samlahde/embedded_systems_course/README.md

# embedded_systems_course
Robotic car for embedded systems project course
