samlahde/embedded_systems_course/shield/ardu_auto2_0.kicad_pcb

## KiCad design shield/ardu_auto2_0.kicad_pcb (2022-03-04)

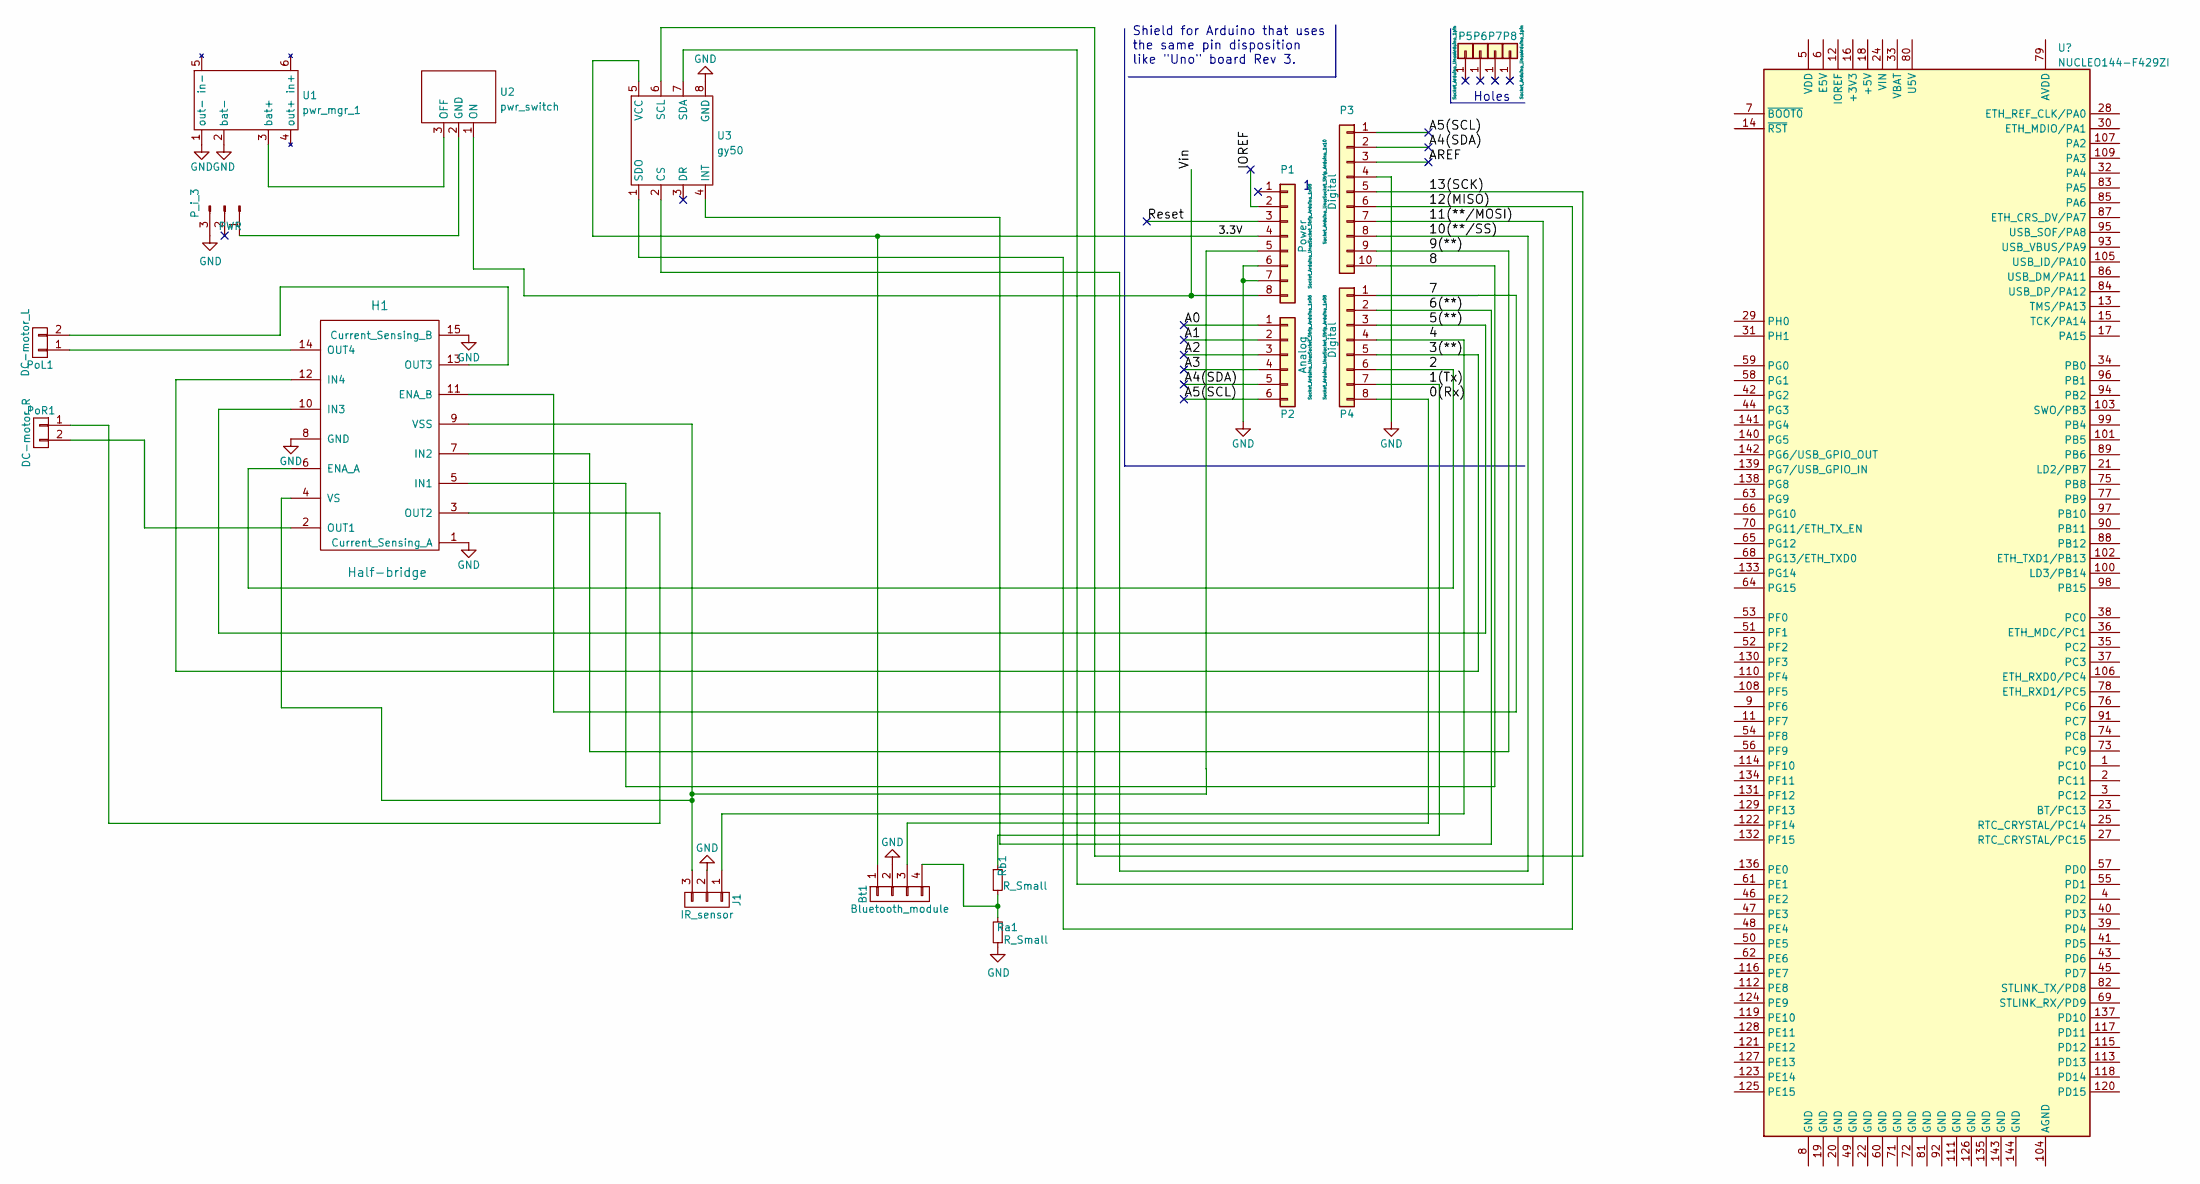
[picture p3: schematic ardu_auto2_0.kicad_sch]

Parts:
Bt1: Bluetooth_module; PinHeader_1x04_P2.54mm_Vertical
H1: Half-bridge
J1: IR_sensor; PinHeader_1x03_P2.54mm_Vertical
P1: Power; Socket_Strip_Arduino_1x08
P2: Analog; Socket_Strip_Arduino_1x06
P3: Digital; Socket_Strip_Arduino_1x10
P4: Digital; Socket_Strip_Arduino_1x08
P5, P6, P7, P8: CONN_01X01; Arduino_1pin
P_i_3: PWR; PinHeader_1x03_P2.54mm_Horizontal
PoL1: DC-motor_L; PinHeader_1x02_P2.54mm_Horizontal
PoR1: DC-motor_R; PinHeader_1x02_P2.54mm_Horizontal
Ra1: R_Small; PinHeader_1x02_P2.54mm_Horizontal
Rb1: R_Small; PinHeader_1x02_P2.54mm_Horizontal
U1: pwr_mgr_1; pwr_mfr_1
U2: pwr_switch; pwr_stw
U3: gy50

Connections:
/0(Rx): Bt1.3, P4.8
/1(Tx): P4.7, Rb1.1
/2: H1.6 (ENA_A), P4.6
/3(**): H1.12 (IN4), P4.5
/3.3V: Bt1.1, P1.4, U3.5 (VCC)
/4: J1.1, P4.4
/5(**): H1.10 (IN3), P4.3
/6(**): P4.2, U3.4 (INT)
/7: H1.11 (ENA_B), P4.1
/8: H1.5 (IN1), P3.10
/9(**): H1.7 (IN2), P3.9
/10(**/SS): P3.8, U3.2 (CS)
/11(**/MOSI): P3.7, U3.7 (SDA)
/12(MISO): P3.6, U3.1 (SDO)
/13(SCK): P3.5, U3.6 (SCL)
/A0: P2.1
/A1: P2.2
/A2: P2.3
/A3: P2.4
/A4(SDA): P2.5, P3.2
/A5(SCL): P2.6, P3.1
/AREF: P3.3
/IOREF: P1.2
/Reset: P1.3
/Vin: P1.8, U2.1 (ON)
GND: Bt1.2, H1.1 (Current_Sensing_A), H1.8 (GND), H1.15 (Current_Sensing_B), J1.2, P1.6, P1.7, P3.4, P_i_3.3, Ra1.1, U1.1 (out-), U1.2 (bat-), U3.8 (GND)
unnamed: Bt1.4, Ra1.2, Rb1.2
unnamed: H1.2 (OUT1), PoR1.2
unnamed: H1.3 (OUT2), PoR1.1
unnamed: H1.13 (OUT3), PoL1.2
unnamed: H1.14 (OUT4), PoL1.1
unnamed: H1.4 (VS), H1.9 (VSS), J1.3, P1.5
unnamed: P_i_3.1, U2.2 (GND)
unnamed: U1.3 (bat+), U2.3 (OFF)

Notes on the sheet:
Shield for Arduino that uses the same pin disposition like "Uno" board Rev 3.
Holes

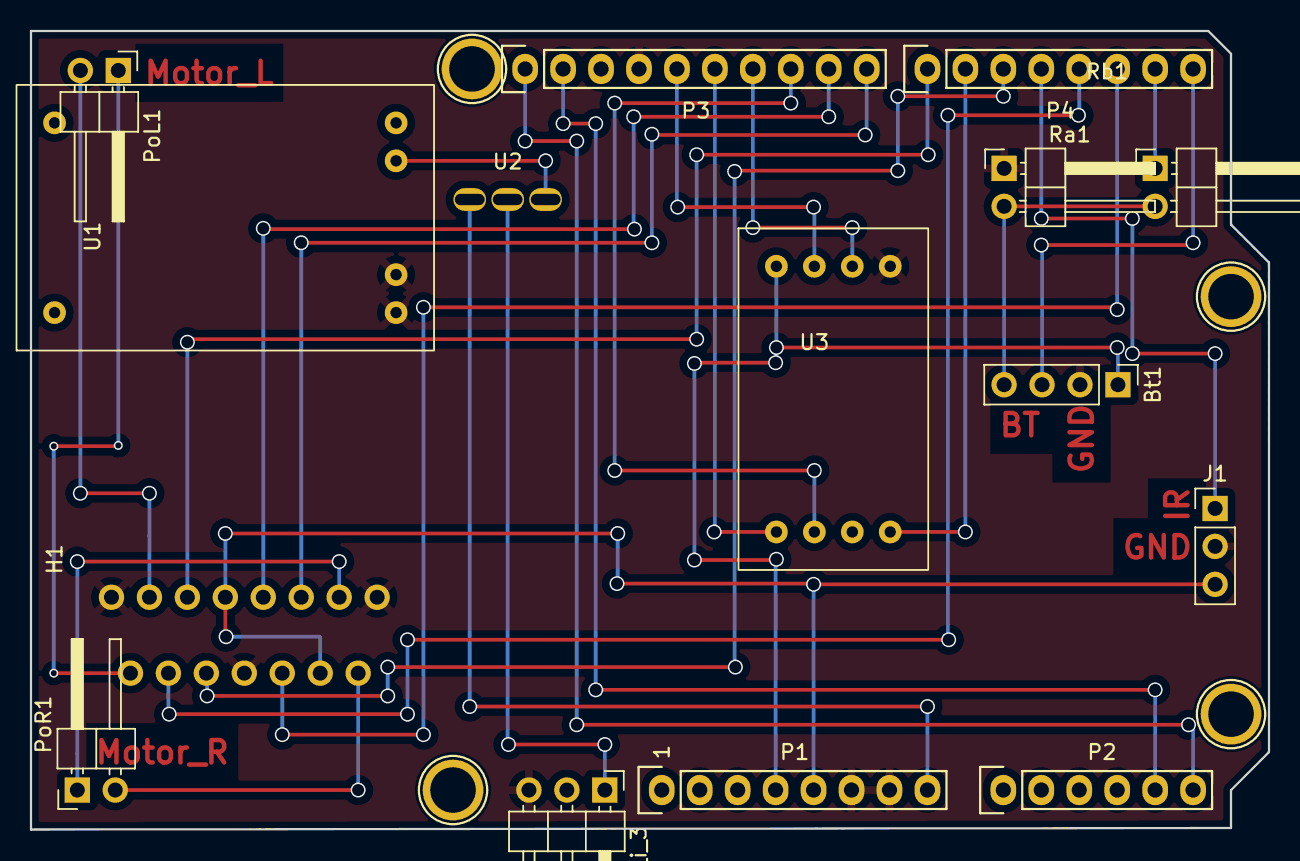
[picture p4: board ardu_auto2_0.kicad_pcb from above]

Board: 2 copper layers, 82.9 x 53.4 mm, 19 parts (0 on the bottom side), 27 nets.
