samlahde/embedded_systems_course/(threads)

Thread 3 (2022-03-03):

Shield schematics NOK

durduino, 2022-03-03:
Current shield branch schematics are made to Arduino Uno, change them to Nucleo-F429ZI board and draw footprint of the battery charger again

durduino, 2022-04-02:
Schematics fixed

Closed 2022-04-02.
