samlahde/embedded_systems_course/Ardu_auto_v000/Core/Src/main.c

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
/* Includes ------------------------------------------------------------------*/
#include "main.h"

/* USER CODE BEGIN Includes */
#include <stdio.h>
#include <stdlib.h>
#include <L3G4200D.h>
#include <string.h>
#include "cmd.h"
#include "motor_control.h"
#include "bt_control.h"
#include "self_driving.h"
#include <stdbool.h>

/* USER CODE END Includes */

/* USER CODE BEGIN PD */
#define PRINT_FREQ 3
/* USER CODE END PD */

 ADC_HandleTypeDef hadc3;
DMA_HandleTypeDef hdma_adc3;

SPI_HandleTypeDef hspi1;

UART_HandleTypeDef huart2;
UART_HandleTypeDef huart6;

/* USER CODE BEGIN PV */
L3G4200D_output Get_gyro_values(void);
/* USER CODE END PV */

void SystemClock_Config(void);
static void MX_GPIO_Init(void);
static void MX_USART2_UART_Init(void);
static void MX_DMA_Init(void);
static void MX_USART6_UART_Init(void);
static void MX_ADC3_Init(void);
static void MX_SPI1_Init(void);
/* USER CODE BEGIN PFP */

//For printing debug data into monitoring
int __io_putchar(int ch)
{
	ITM_SendChar(ch);
	return(ch);
}

/* USER CODE END PFP */

/**
  * @brief  The application entry point.
  * @retval int
  */
int main(void)
{
  /* USER CODE BEGIN 1 */

  uint32_t IR_data[5];
  //L3G4200D_output gyro_data;
  Cmd_holder cmd_holder = (Cmd_holder)malloc(sizeof(uint8_t) * 4);
  uint8_t bt_msg;
  int print_iterator = 0;

  cmd_holder->new_cmd = CMD_NONE;
  cmd_holder->old_cmd = CMD_NONE;
  cmd_holder->moving = STOPPED;
  cmd_holder->mode = MODE_MANUAL;
  /* USER CODE END 1 */

  /* MCU Configuration--------------------------------------------------------*/

  /* Reset of all peripherals, Initializes the Flash interface and the Systick. */
  HAL_Init();

  /* Configure the system clock */
  SystemClock_Config();

  /* Initialize all configured peripherals */
  MX_GPIO_Init();
  MX_USART2_UART_Init();
  MX_DMA_Init();
  MX_USART6_UART_Init();
  MX_ADC3_Init();
  MX_SPI1_Init();
  /* USER CODE BEGIN 2 */

  //SPI TX off
  HAL_GPIO_WritePin(GPIOF, SPI_CS_Pin, GPIO_PIN_SET);
  /* USER CODE END 2 */

  /* Infinite loop */
  /* USER CODE BEGIN WHILE */
  while (1)
  {

    /* USER CODE END WHILE */

    /* USER CODE BEGIN 3 */
	  /*IR ADC
	   * HAL ADC3 DMA values
	   * IR_data[0] = IR1 ... IR_data[4] = IR5
	   * IR_data[n] = 4095 -> distance > 10 cm
	   * IR_data[n] = 100-300 -> distance < 10 cm
	   * */

	  HAL_ADC_Start_DMA(&hadc3, IR_data, 5);
	  bt_msg = get_bt_msg();
	  handle_bt_msg(bt_msg, cmd_holder);

	  if(cmd_holder->mode == MODE_SELF_DRIVE){
	      self_driving(cmd_holder, IR_data);
	  }
	  handle_driving(cmd_holder);

	  if(print_iterator >= PRINT_FREQ){
	      print_driving_state(cmd_holder);
	      print_iterator = 0;
	  }
	  print_iterator++;
	  /*GY-50
	   * HAL SPI 1 Bus
	   * Addresses in L3G4200D.h library
	   * */


	  //gyro_data = Get_gyro_values();
	  //printf("%d %d %d \r\n", gyro_data.x, gyro_data.y, gyro_data.z);

	  // Delay for readability
	  //HAL_Delay(1000);
  }
  /* USER CODE END 3 */
}

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
/* USER CODE BEGIN 4 */
void SPIWrite(uint8_t address, uint8_t data)
{
  address |= 0x40;
  //SPI TX on
  HAL_GPIO_WritePin(GPIOD, SPI_CS_Pin, GPIO_PIN_RESET);
  //SPI address transmit
  HAL_SPI_Transmit(&hspi1, &address, sizeof(address), HAL_MAX_DELAY);
  //SPI data transmit
  HAL_SPI_Transmit(&hspi1, &data, sizeof(data), HAL_MAX_DELAY);
  //SPI TX off
  HAL_GPIO_WritePin(GPIOD, SPI_CS_Pin, GPIO_PIN_SET);
}

uint8_t SPIRead(uint8_t address)
{
  uint8_t data;
  address |= 0xA0;
  //SPI TX on
  HAL_GPIO_WritePin(GPIOD, SPI_CS_Pin, GPIO_PIN_RESET);
  //SPI address transmit
  HAL_SPI_Transmit(&hspi1, &address, sizeof(address), HAL_MAX_DELAY);
  //SPI data receive
  HAL_SPI_Receive(&hspi1, &data, sizeof(data), HAL_MAX_DELAY);
  //SPI TX off
  HAL_GPIO_WritePin(GPIOD, SPI_CS_Pin, GPIO_PIN_SET);
  return data;
}


uint8_t get_bt_msg() {
  uint8_t msg;
  HAL_UART_Receive(&huart6, &msg, sizeof(msg), 500);
  printf("%d\r\n", msg);
  return msg;
}

L3G4200D_output Get_gyro_values()
{
	uint8_t x_l,x_h,y_l,y_h,z_l,z_h;
	L3G4200D_output gyro_data;
//	x_l = SPIRead(L3G4200D_REG_OUT_X_L);
//	x_h = SPIRead(L3G4200D_REG_OUT_X_H);
//	y_l = SPIRead(L3G4200D_REG_OUT_Y_L);
//	y_h = SPIRead(L3G4200D_REG_OUT_Y_H);
//	z_l = SPIRead(L3G4200D_REG_OUT_Z_L);
//	z_h = SPIRead(L3G4200D_REG_OUT_Z_H);
//	gyro_data.x = (x_l & 0xFF) | ((x_h & 0xFF) << 8);
//	gyro_data.y = (y_l & 0xFF) | ((y_h & 0xFF) << 8);
//	gyro_data.z = (z_l & 0xFF) | ((z_h & 0xFF) << 8);
	x_l = SPIRead(ADXL345_REG_DATAX0);
	x_h = SPIRead(ADXL345_REG_DATAX1);
	y_l = SPIRead(ADXL345_REG_DATAY0);
	y_h = SPIRead(ADXL345_REG_DATAY1);
	z_l = SPIRead(ADXL345_REG_DATAZ0);
	z_h = SPIRead(ADXL345_REG_DATAZ1);
	gyro_data.x = x_l | (x_h << 8);
	gyro_data.y = y_l | (y_h << 8);
	gyro_data.z = z_l | (z_h << 8);

	return gyro_data;
}

void gyroInit()
{
  //uint8_t scale, status;
  //status = SPIRead(L3G4200D_REG_WHO_AM_I);
  /*printf("%d\r\n", status);
  // Enable x, y, z and turn off power down mode:
  SPIWrite(L3G4200D_REG_CTRL_REG1, 0x0f);
  // HPF
  SPIWrite(L3G4200D_REG_CTRL_REG2, 0);
  // Configure CTRL_REG3 to generate data ready interrupt on INT2
  // No interrupts used on INT1, if you'd like to configure INT1
  // or INT2 otherwise, consult the datasheet:
  SPIWrite(L3G4200D_REG_CTRL_REG3, 0);
  // CTRL_REG4 controls the full-scale range, among other things:
  scale = 2 & 0x03;
  SPIWrite(L3G4200D_REG_CTRL_REG4, scale << 4);
  // CTRL_REG5 controls high-pass filtering of outputs, use it
  // if you'd like:
  SPIWrite(L3G4200D_REG_CTRL_REG5, 0);*/
  SPIWrite(ADXL345_REG_DATA_FORMAT , 0x0B);
  SPIWrite(ADXL345_REG_POWER_CTL , 0);
  SPIWrite(ADXL345_REG_POWER_CTL , 8);
  uint8_t me;
  me = SPIRead(ADXL345_REG_DEVID);
  printf(" Device ID: %d\r\n", me);

}

/* USER CODE END 4 */
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
