samlahde/embedded_systems_course/Ardu_auto_v000/Core/Inc/main.h

#define IR3_Pin GPIO_PIN_3
#define IR3_GPIO_Port GPIOF
#define IR2_Pin GPIO_PIN_5
#define IR2_GPIO_Port GPIOF
#define IR1_Pin GPIO_PIN_10
#define IR1_GPIO_Port GPIOF
#define IR5_Pin GPIO_PIN_0
#define IR5_GPIO_Port GPIOC
#define IR4_Pin GPIO_PIN_3
#define IR4_GPIO_Port GPIOC
#define SCK_Pin GPIO_PIN_5
#define SCK_GPIO_Port GPIOA
#define SDO_Pin GPIO_PIN_6
#define SDO_GPIO_Port GPIOA
#define SDA_Pin GPIO_PIN_7
#define SDA_GPIO_Port GPIOA
#define IN1_Pin GPIO_PIN_12
#define IN1_GPIO_Port GPIOF
#define ENB_Pin GPIO_PIN_13
#define ENB_GPIO_Port GPIOF
#define ENA_Pin GPIO_PIN_15
#define ENA_GPIO_Port GPIOF
#define SPI_INT_Pin GPIO_PIN_9
#define SPI_INT_GPIO_Port GPIOE
#define IN3_Pin GPIO_PIN_11
#define IN3_GPIO_Port GPIOE
#define IN4_Pin GPIO_PIN_13
#define IN4_GPIO_Port GPIOE
#define SPI_CS_Pin GPIO_PIN_14
#define SPI_CS_GPIO_Port GPIOD
#define IN2_Pin GPIO_PIN_15
#define IN2_GPIO_Port GPIOD
#define BT_RX_Pin GPIO_PIN_9
#define BT_RX_GPIO_Port GPIOG
#define BT_TX_Pin GPIO_PIN_14
#define BT_TX_GPIO_Port GPIOG
