samlahde/embedded_systems_course/Ardu_auto_v000/Core/Src/motor_control.c

/*
 * motor_control.c
 *
 *  Created on: Apr 3, 2022
 *      Author: samul
 */

#include "main.h"
#include <stdio.h>
#include <L3G4200D.h>
#include <string.h>
#include "bt_control.h"
#include "motor_control.h"

	  /*Motor control
	   * Outputs:
	   * GPIOF, ENA_Pin = Motor 1 enable signal
	   * GPIOF, IN1_Pin = Motor 1 A signal
	   * GPIOD, IN2_Pin = Motor 1 B signal
	   * ENB_GPIO_Port, ENB_Pin = Motor 2 enable signal
	   * GPIOE, IN3_Pin = Motor 2 A signal
	   * GPIOE, IN4_Pin = Motor 2 B signal
	   *
	   * GPIO_PIN_SET = High
	   * GPIO_PIN_RESET = LOW
	   * enable high:
	   * A high, B low -> forward
	   * A low, B high -> reverse
	   * A high, B high -> fast motor stop
	   *
	   * enable low -> motor stop
	   * */

void motor_set(uint8_t motor, uint8_t command){
	switch(motor){
		case LEFT_MT:
			switch(command){
				case MT_FORWARD:
					HAL_GPIO_WritePin(GPIOF, ENA_Pin, GPIO_PIN_SET);
					HAL_GPIO_WritePin(GPIOF, IN1_Pin, GPIO_PIN_SET);
					HAL_GPIO_WritePin(GPIOD, IN2_Pin, GPIO_PIN_RESET);
					break;
				case MT_REVERSE:
					HAL_GPIO_WritePin(GPIOF, ENA_Pin, GPIO_PIN_SET);
					HAL_GPIO_WritePin(GPIOF, IN1_Pin, GPIO_PIN_RESET);
					HAL_GPIO_WritePin(GPIOD, IN2_Pin, GPIO_PIN_SET);
					break;
				case MT_STOP:
					HAL_GPIO_WritePin(GPIOF, ENA_Pin, GPIO_PIN_RESET);
					break;
				case MT_FAST_STOP:
					HAL_GPIO_WritePin(GPIOF, ENA_Pin, GPIO_PIN_SET);
					HAL_GPIO_WritePin(GPIOF, IN1_Pin, GPIO_PIN_SET);
					HAL_GPIO_WritePin(GPIOD, IN2_Pin, GPIO_PIN_SET);
					break;
			}
		case RIGHT_MT:
			switch(command){
				case MT_FORWARD:
					HAL_GPIO_WritePin(ENB_GPIO_Port, ENB_Pin, GPIO_PIN_SET);
					HAL_GPIO_WritePin(GPIOE, IN3_Pin, GPIO_PIN_SET);
					HAL_GPIO_WritePin(GPIOE, IN4_Pin, GPIO_PIN_RESET);
					break;
				case MT_REVERSE:
					HAL_GPIO_WritePin(ENB_GPIO_Port, ENB_Pin, GPIO_PIN_SET);
					HAL_GPIO_WritePin(GPIOE, IN3_Pin, GPIO_PIN_RESET);
					HAL_GPIO_WritePin(GPIOE, IN4_Pin, GPIO_PIN_SET);
					break;
				case MT_STOP:
					HAL_GPIO_WritePin(ENB_GPIO_Port, ENB_Pin, GPIO_PIN_RESET);
					break;
				case MT_FAST_STOP:
					HAL_GPIO_WritePin(ENB_GPIO_Port, ENB_Pin, GPIO_PIN_SET);
					HAL_GPIO_WritePin(GPIOE, IN3_Pin, GPIO_PIN_SET);
					HAL_GPIO_WritePin(GPIOE, IN4_Pin, GPIO_PIN_SET);
					break;
		}
	}
}

void handle_driving(Cmd_holder cmd){
	uint8_t old = cmd->old_cmd;
	uint8_t new = cmd->new_cmd;
	if (new != old && new != CMD_NONE){
		switch(new){
		    case CMD_FORWARD:
		    	motor_set(LEFT_MT, MT_FORWARD);
		    	motor_set(RIGHT_MT, MT_FORWARD);
		    	cmd->moving = MOVING_FORWARD;
		    	break;

		    case CMD_REVERSE:
				motor_set(LEFT_MT, MT_REVERSE);
				motor_set(RIGHT_MT, MT_REVERSE);
				cmd->moving = MOVING_REVERSE;
				break;

		    case CMD_STOP:
		    	motor_set(LEFT_MT, MT_STOP);
				motor_set(RIGHT_MT, MT_STOP);
				cmd->moving = STOPPED;
				break;

		    case CMD_FAST_STOP:
		    	motor_set(LEFT_MT, MT_FAST_STOP);
		    	motor_set(RIGHT_MT, MT_FAST_STOP);
		    	cmd->moving = STOPPED;
		    	break;

			case CMD_TURN_LEFT_FWD:
				motor_set(LEFT_MT, MT_STOP);
				motor_set(RIGHT_MT, MT_FORWARD);
				cmd->moving = MOVING_FORWARD;
				break;

			case CMD_TURN_LEFT_REV:
				motor_set(LEFT_MT, MT_STOP);
				motor_set(RIGHT_MT, MT_REVERSE);
				cmd->moving = MOVING_REVERSE;
				break;

			case CMD_TURN_LEFT_STOPPED:
				motor_set(LEFT_MT, MT_REVERSE);
				motor_set(RIGHT_MT, MT_FORWARD);
				cmd->moving = STOPPED;
				break;

			case CMD_TURN_RIGHT_FWD:
				motor_set(LEFT_MT, MT_FORWARD);
				motor_set(RIGHT_MT, MT_STOP);
				cmd->moving = MOVING_FORWARD;
				break;

			case CMD_TURN_RIGHT_REV:
				motor_set(LEFT_MT, MT_REVERSE);
				motor_set(RIGHT_MT, MT_STOP);
				cmd->moving = MOVING_REVERSE;
				break;

			case CMD_TURN_RIGHT_STOPPED:
				motor_set(LEFT_MT, MT_FORWARD);
				motor_set(RIGHT_MT, MT_REVERSE);
				cmd->moving = STOPPED;
				break;

			default:
				break;
		}
		cmd->old_cmd = new;
	}
}

void print_driving_state(Cmd_holder cmd){
	uint8_t left_state, right_state;
	left_state = get_motor_state(LEFT_MT);
	right_state = get_motor_state(RIGHT_MT);
	if(left_state == MT_FORWARD && right_state == MT_REVERSE){
		printf("Turning right in place\r\n");
	}
	else if(left_state == MT_REVERSE && right_state == MT_FORWARD){
			printf("Turning left in place\r\n");
		}
	else if (left_state == MT_FORWARD && right_state != MT_FORWARD){
		printf("Turning forward right\r\n");
	}
	else if(left_state != MT_FORWARD && right_state == MT_FORWARD){
		printf("Turning forward left\r\n");
	}
	else if(left_state == MT_REVERSE && right_state != MT_REVERSE){
			printf("Turning reverse right\r\n");
		}
	else if(left_state != MT_REVERSE && right_state == MT_REVERSE){
			printf("Turning reverse left\r\n");
		}
	else if(left_state == MT_FORWARD && right_state == MT_FORWARD){
			printf("Moving forward\r\n");
		}
	else if(left_state == MT_REVERSE && right_state == MT_REVERSE){
			printf("Moving reverse\r\n");
		}
	else
		printf("Stopped\r\n");

}

uint8_t get_motor_state(uint8_t motor){
	uint8_t motor_state = MT_STOP;
	GPIO_PinState enable, in1, in2;
	if(motor == LEFT_MT){
		enable = HAL_GPIO_ReadPin(GPIOF, ENA_Pin);
		in1 = HAL_GPIO_ReadPin(GPIOF, IN1_Pin);
		in2 = HAL_GPIO_ReadPin(GPIOD, IN2_Pin);
	}
	else if(motor == RIGHT_MT){
		enable = HAL_GPIO_ReadPin(ENB_GPIO_Port, ENB_Pin);
		in1 = HAL_GPIO_ReadPin(GPIOE, IN3_Pin);
		in2 = HAL_GPIO_ReadPin(GPIOE, IN4_Pin);
	}
	if(enable){
		if(in1 && !in2){
			motor_state = MT_FORWARD;
		}
		else if(!in1 && in2){
			motor_state = MT_REVERSE;
		}
	}
	return motor_state;

}
