samlahde/embedded_systems_course/Ardu_auto_v000/Core/Inc/L3G4200D.h

/*
 * L3G4200D.h
 *
 *  Created on: Mar 3, 2022
 *      Author: halako
 */

#ifndef INC_L3G4200D_H_
#define INC_L3G4200D_H_

/*************************
    L3G4200D Registers
*************************/
#define L3G4200D_ADDRESS           (0xD2 >> 1)

#define L3G4200D_REG_WHO_AM_I      (0x0F)

#define L3G4200D_REG_CTRL_REG1     (0x20)
#define L3G4200D_REG_CTRL_REG2     (0x21)
#define L3G4200D_REG_CTRL_REG3     (0x22)
#define L3G4200D_REG_CTRL_REG4     (0x23)
#define L3G4200D_REG_CTRL_REG5     (0x24)
#define L3G4200D_REG_REFERENCE     (0x25)
#define L3G4200D_REG_OUT_TEMP      (0x26)
#define L3G4200D_REG_STATUS_REG    (0x27)

#define L3G4200D_REG_OUT_X_L       (0x28)
#define L3G4200D_REG_OUT_X_H       (0x29)
#define L3G4200D_REG_OUT_Y_L       (0x2A)
#define L3G4200D_REG_OUT_Y_H       (0x2B)
#define L3G4200D_REG_OUT_Z_L       (0x2C)
#define L3G4200D_REG_OUT_Z_H       (0x2D)

#define L3G4200D_REG_FIFO_CTRL_REG (0x2E)
#define L3G4200D_REG_FIFO_SRC_REG  (0x2F)

#define L3G4200D_REG_INT1_CFG      (0x30)
#define L3G4200D_REG_INT1_SRC      (0x31)
#define L3G4200D_REG_INT1_THS_XH   (0x32)
#define L3G4200D_REG_INT1_THS_XL   (0x33)
#define L3G4200D_REG_INT1_THS_YH   (0x34)
#define L3G4200D_REG_INT1_THS_YL   (0x35)
#define L3G4200D_REG_INT1_THS_ZH   (0x36)
#define L3G4200D_REG_INT1_THS_ZL   (0x37)
#define L3G4200D_REG_INT1_DURATION (0x38)

#define L3G4200D_ADDR (0xD2 >> 1)

#define L3G4200D_CTRL_REG4_CONST_UPDATE 0b10000000
#define L3G4200D_CTRL_REG4_SCALE_250 0x00
#define L3G4200D_CTRL_REG4_SCALE_500 0b00010000
#define L3G4200D_CTRL_REG4_SCALE_2000 0b00100000

#define L3G4200D_CTRL_REG1_ON 0b00001111

#define L3G4200D_OUT_INCREMENT 0x28 | (1<<7)

#define Register_ID 0
#define POWER_CTL  0x2D
#define Register_X0 0x32
#define Register_X1 0x33
#define Register_Y0 0x34
#define Register_Y1 0x35
#define Register_Z0 0x36
#define Register_Z1 0x37
#define ADXAddress 0x53
#define DATA_FORMAT 0x31

#define ADXL345_REG_DEVID (0x00)        ///< Device ID
#define ADXL345_REG_THRESH_TAP (0x1D)   ///< Tap threshold
#define ADXL345_REG_OFSX (0x1E)         ///< X-axis offset
#define ADXL345_REG_OFSY (0x1F)         ///< Y-axis offset
#define ADXL345_REG_OFSZ (0x20)         ///< Z-axis offset
#define ADXL345_REG_DUR (0x21)          ///< Tap duration
#define ADXL345_REG_LATENT (0x22)       ///< Tap latency
#define ADXL345_REG_WINDOW (0x23)       ///< Tap window
#define ADXL345_REG_THRESH_ACT (0x24)   ///< Activity threshold
#define ADXL345_REG_THRESH_INACT (0x25) ///< Inactivity threshold
#define ADXL345_REG_TIME_INACT (0x26)   ///< Inactivity time
#define ADXL345_REG_ACT_INACT_CTL (0x27) ///< Axis enable control for activity and inactivity detection
#define ADXL345_REG_THRESH_FF (0x28) ///< Free-fall threshold
#define ADXL345_REG_TIME_FF (0x29)   ///< Free-fall time
#define ADXL345_REG_TAP_AXES (0x2A)  ///< Axis control for single/double tap
#define ADXL345_REG_ACT_TAP_STATUS (0x2B) ///< Source for single/double tap
#define ADXL345_REG_BW_RATE (0x2C)        ///< Data rate and power mode control
#define ADXL345_REG_POWER_CTL (0x2D)      ///< Power-saving features control
#define ADXL345_REG_INT_ENABLE (0x2E)     ///< Interrupt enable control
#define ADXL345_REG_INT_MAP (0x2F)        ///< Interrupt mapping control
#define ADXL345_REG_INT_SOURCE (0x30)     ///< Source of interrupts
#define ADXL345_REG_DATA_FORMAT (0x31)    ///< Data format control
#define ADXL345_REG_DATAX0 (0x32)         ///< X-axis data 0
#define ADXL345_REG_DATAX1 (0x33)         ///< X-axis data 1
#define ADXL345_REG_DATAY0 (0x34)         ///< Y-axis data 0
#define ADXL345_REG_DATAY1 (0x35)         ///< Y-axis data 1
#define ADXL345_REG_DATAZ0 (0x36)         ///< Z-axis data 0
#define ADXL345_REG_DATAZ1 (0x37)         ///< Z-axis data 1
#define ADXL345_REG_FIFO_CTL (0x38)       ///< FIFO control
#define ADXL345_REG_FIFO_STATUS (0x39)    ///< FIFO status

//#ifndef VECTOR_STRUCT_H
//#define VECTOR_STRUCT_H
typedef struct Vector
{
	uint16_t x, y, z;
} L3G4200D_output;
//#endif

typedef enum
{
    L3G4200D_SCALE_2000DPS = 0b10,
    L3G4200D_SCALE_500DPS  = 0b01,
    L3G4200D_SCALE_250DPS  = 0b00
} l3g4200d_dps_t;

typedef enum
{
    L3G4200D_DATARATE_800HZ_110  = 0b1111,
    L3G4200D_DATARATE_800HZ_50   = 0b1110,
    L3G4200D_DATARATE_800HZ_35   = 0b1101,
    L3G4200D_DATARATE_800HZ_30   = 0b1100,
    L3G4200D_DATARATE_400HZ_110  = 0b1011,
    L3G4200D_DATARATE_400HZ_50   = 0b1010,
    L3G4200D_DATARATE_400HZ_25   = 0b1001,
    L3G4200D_DATARATE_400HZ_20   = 0b1000,
    L3G4200D_DATARATE_200HZ_70   = 0b0111,
    L3G4200D_DATARATE_200HZ_50   = 0b0110,
    L3G4200D_DATARATE_200HZ_25   = 0b0101,
    L3G4200D_DATARATE_200HZ_12_5 = 0b0100,
    L3G4200D_DATARATE_100HZ_25   = 0b0001,
    L3G4200D_DATARATE_100HZ_12_5 = 0b0000
} l3g4200d_odrbw_t;

#endif /* INC_L3G4200D_H_ */
