samlahde/embedded_systems_course/(commit log)

2022-02-11 Document templates
    Added document templates to git
    [BOM.xlsx]
2022-03-01 Laturi skemat
    Lisätty kansio jossa kaikki laturin kicad tiedostot
    [sulari_laturi.kicad_pcb, sulari_laturi.kicad_sch]
2022-03-03 Shield template
    Shield template for further use. Replace Uno wires with nucleo
    [ardu_auto2_0.kicad_pcb, ardu_auto2_0.kicad_sch]
2022-03-03 Docs update
    Removed old docs and added report PDF, it will be updated during project
    [BOM.xlsx]
2022-03-25 Init 2
    Added functions and SPI
2022-04-01 bug fix
    Gyro working, added functions
    [L3G4200D.h, main.c]
2022-04-02 bug fix
    Pin fix
    [Ardu_auto_v000.ioc, main.c, main.h]
2022-04-07 Initial draft for motor control
2022-04-08 Add function to print actual mt pin values 4 debug
2022-04-09 Bug fix
    Added continuous driving to X, stopping to Y, little move forward to up and little reverse to down. Fixed cases,
    [bt_control.c, bt_control.h, main.c, motor_control.c, motor_control.h]
2022-04-14 Major rework, add self driving draft
    -Moved command structure to new header file
    -Moved move command logic from motor_control to bt_control for increased modularity
    -Created a draft of autonomous driving functionality
    [bt_control.c, bt_control.h, cmd.h, main.c, main.h, motor_control.c, motor_control.h, self_driving.c]
2022-04-22 Fix to self driving
    [main.c, self_driving.c, self_driving.h]
2022-05-10 fixed gyro regs
2022-05-10 Change print freq
2022-05-10 Stop car when switching to manual
