samlahde/embedded_systems_course/(notices)

Notices in the files:
Ardu_auto_v000/Core/Inc/main.h:
Copyright (c) 2022 STMicroelectronics.
All rights reserved.
This software is licensed under terms that can be found in the LICENSE file
